quentin-z80/ASM1061/README.md

# ASM1061

ASM1061 based PCIe to SATA card

Manufactured using JLCPCB's JLC3313 stackup



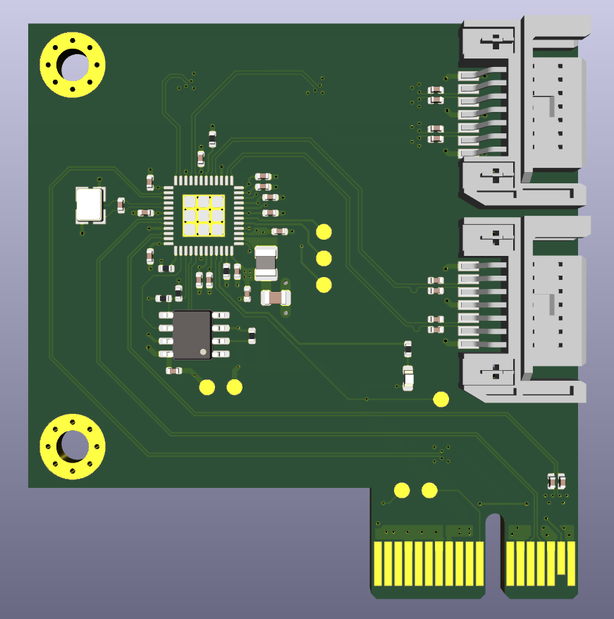
[picture p1: ASM1061_render.png]
