quentin-z80/ASM1061/ASM1061.kicad_pcb

## KiCad design ASM1061.kicad_pcb (2022-08-09)

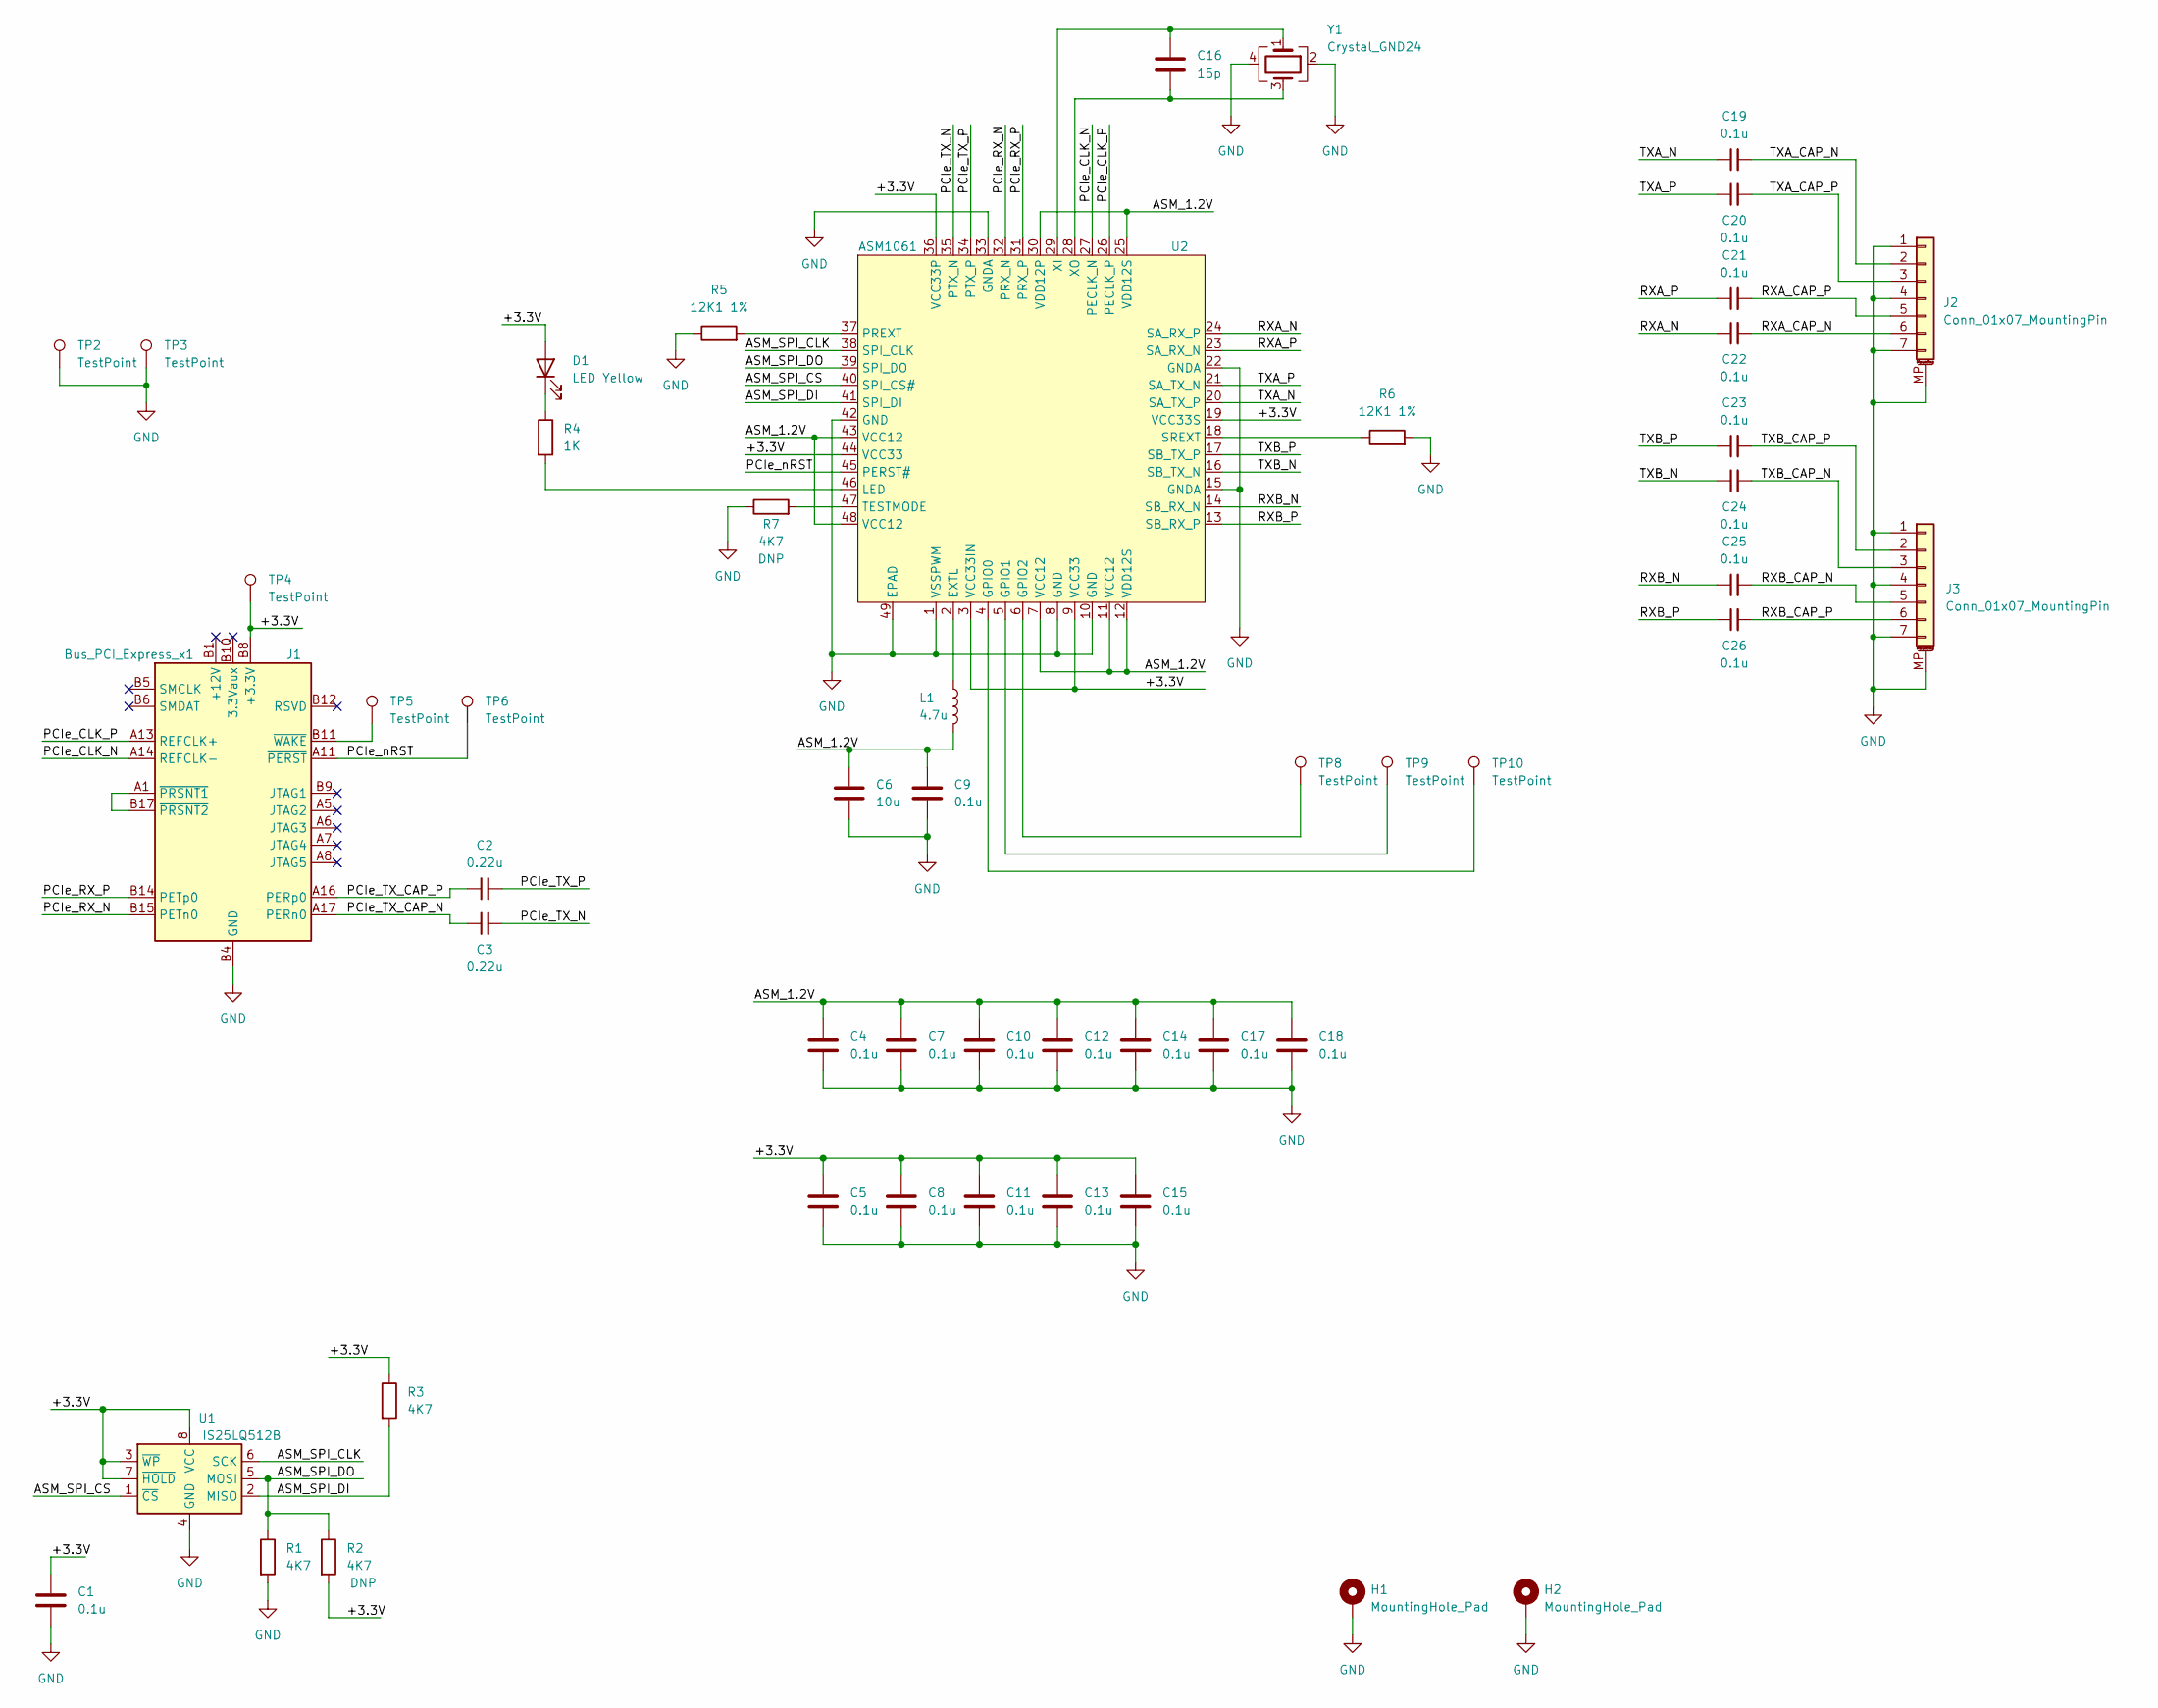
[picture p2: schematic ASM1061.kicad_sch]

Parts:
C1, C4, C5, C7, C8, C9, C10, C11, C12, C13, C14, C15, C17, C18, C19, C20, C21, C22, C23, C24, C25, C26: 0.1u; C_0402_1005Metric; MFG_PN GCM155R71C104KA55D; DigiKey_PN 490-4759-1-ND
C2, C3: 0.22u; C_0402_1005Metric; MFG_PN GCM155R71C224KE02D; DigiKey_PN 490-10671-1-ND
C6: 10u; C_0805_2012Metric; MFG_PN GRM21BR70J106KA73L; DigiKey_PN 490-GRM21BR70J106KA73LCT-ND
C16: 15p; C_0402_1005Metric; MFG_PN GCM1555C1H150JA16D; DigiKey_PN 490-11147-1-ND
D1: LED Yellow; LED_0603_1608Metric; MFG_PN SML-D12Y1WT86; DigiKey_PN SML-D12Y1WT86CT-ND
H1, H2: MountingHole_Pad; MountingHole_3.2mm_M3_Pad_Via
J1: Bus_PCI_Express_x1; BUS_PCIexpress_x1
J2, J3: Conn_01x07_MountingPin; 0674901220; MFG_PN 0470804005; DigiKey_PN WM19112CT-ND
L1: 4.7u; L_1008_2520Metric; MFG_PN CVH252009-4R7M; DigiKey_PN CVH252009-4R7MCT-ND
R1, R2, R3, R7: 4K7; R_0402_1005Metric; MFG_PN RC0402JR-074K7L; DigiKey_PN 311-4.7KJRCT-ND
R4: 1K; R_0402_1005Metric; MFG_PN RC0402JR-071KL; DigiKey_PN 311-1.0KJRCT-ND
R5, R6: 12K1 1%; R_0402_1005Metric; MFG_PN RC0402FR-0712K1L; DigiKey_PN 311-12.1KLRCT-ND
TP2, TP3, TP4, TP5, TP6, TP8, TP9, TP10: TestPoint; TestPoint_Pad_D1.5mm
U1: IS25LQ512B; SOIC-8_3.9x4.9mm_P1.27mm; MFG_PN IS25LQ512B-JNLE; DigiKey_PN 706-1325-ND
U2: ASM1061; VQFN-48-1EP_7x7mm_P0.5mm_EP4.1x4.1mm_ThermalVias
Y1: Crystal_GND24; Crystal_SMD_3225-4Pin_3.2x2.5mm; MFG_PN CX3225SB20000H0FLJCC; DigiKey_PN 1253-1744-1-ND

Connections:
/+3.3V: C1.1, C5.1, C8.1, C11.1, C13.1, C15.1, D1.2 (A), J1.A9 (+3.3V), J1.A10 (+3.3V), J1.B8 (+3.3V), R2.2, R3.1, TP4.1, U1.3 (~WP), U1.7 (~HOLD), U1.8 (VCC), U2.3 (VCC33IN), U2.9 (VCC33), U2.19 (VCC33S), U2.36 (VCC33P), U2.44 (VCC33)
/ASM_1.2V: C4.1, C6.1, C7.1, C9.1, C10.1, C12.1, C14.1, C17.1, C18.1, L1.2, U2.7 (VCC12), U2.11 (VCC12), U2.12 (VDD12S), U2.25 (VDD12S), U2.30 (VDD12P), U2.43 (VCC12), U2.48 (VCC12)
/ASM_SPI_CLK: U1.6 (SCK), U2.38 (SPI_CLK)
/ASM_SPI_CS: U1.1 (~CS), U2.40 (SPI_CS#)
/ASM_SPI_DI: R3.2, U1.2 (MISO), U2.41 (SPI_DI)
/ASM_SPI_DO: R1.1, R2.1, U1.5 (MOSI), U2.39 (SPI_DO)
/PCIe_CLK_N: J1.A14 (REFCLK-), U2.27 (PECLK_N)
/PCIe_CLK_P: J1.A13 (REFCLK+), U2.26 (PECLK_P)
/PCIe_RX_N: J1.B15 (PETn0), U2.32 (PRX_N)
/PCIe_RX_P: J1.B14 (PETp0), U2.31 (PRX_P)
/PCIe_TX_CAP_N: C3.1, J1.A17 (PERn0)
/PCIe_TX_CAP_P: C2.1, J1.A16 (PERp0)
/PCIe_TX_N: C3.2, U2.35 (PTX_N)
/PCIe_TX_P: C2.2, U2.34 (PTX_P)
/PCIe_nRST: J1.A11 (~PERST), TP6.1, U2.45 (PERST#)
/RXA_CAP_N: C22.2, J2.6
/RXA_CAP_P: C21.2, J2.5
/RXA_N: C22.1, U2.24 (SA_RX_P)
/RXA_P: C21.1, U2.23 (SA_RX_N)
/RXB_CAP_N: C25.2, J3.5
/RXB_CAP_P: C26.2, J3.6
/RXB_N: C25.1, U2.14 (SB_RX_N)
/RXB_P: C26.1, U2.13 (SB_RX_P)
/TXA_CAP_N: C19.2, J2.2
/TXA_CAP_P: C20.2, J2.3
/TXA_N: C19.1, U2.20 (SA_TX_P)
/TXA_P: C20.1, U2.21 (SA_TX_N)
/TXB_CAP_N: C24.2, J3.3
/TXB_CAP_P: C23.2, J3.2
/TXB_N: C24.1, U2.16 (SB_TX_N)
/TXB_P: C23.1, U2.17 (SB_TX_P)
GND: C1.2, C4.2, C5.2, C6.2, C7.2, C8.2, C9.2, C10.2, C11.2, C12.2, C13.2, C14.2, C15.2, C17.2, C18.2, H1.1, H2.1, J1.A4 (GND), J1.A12 (GND), J1.A15 (GND), J1.A18 (GND), J1.B4 (GND), J1.B7 (GND), J1.B13 (GND), J1.B16 (GND), J1.B18 (GND), J2.1, J2.4, J2.7, J2.MP (MountPin), J3.1, J3.4, J3.7, J3.MP (MountPin), R1.2, R5.1, R6.2, R7.1, TP2.1, TP3.1, U1.4 (GND), U2.1 (VSSPWM), U2.8 (GND), U2.10 (GND), U2.15 (GNDA), U2.22 (GNDA), U2.33 (GNDA), U2.42 (GND), U2.49 (EPAD), Y1.2, Y1.4
unnamed: C16.1, U2.29 (XI), Y1.1
unnamed: C16.2, U2.28 (XO), Y1.3
unnamed: D1.1 (K), R4.1
unnamed: J1.A1 (~PRSNT1), J1.B17 (~PRSNT2)
unnamed: J1.B11 (~WAKE), TP5.1
unnamed: L1.1, U2.2 (EXTL)
unnamed: R4.2, U2.46 (LED)
unnamed: R5.2, U2.37 (PREXT)
unnamed: R6.1, U2.18 (SREXT)
unnamed: R7.2, U2.47 (TESTMODE)
unnamed: TP8.1, U2.6 (GPIO2)
unnamed: TP9.1, U2.5 (GPIO1)
unnamed: TP10.1, U2.4 (GPIO0)

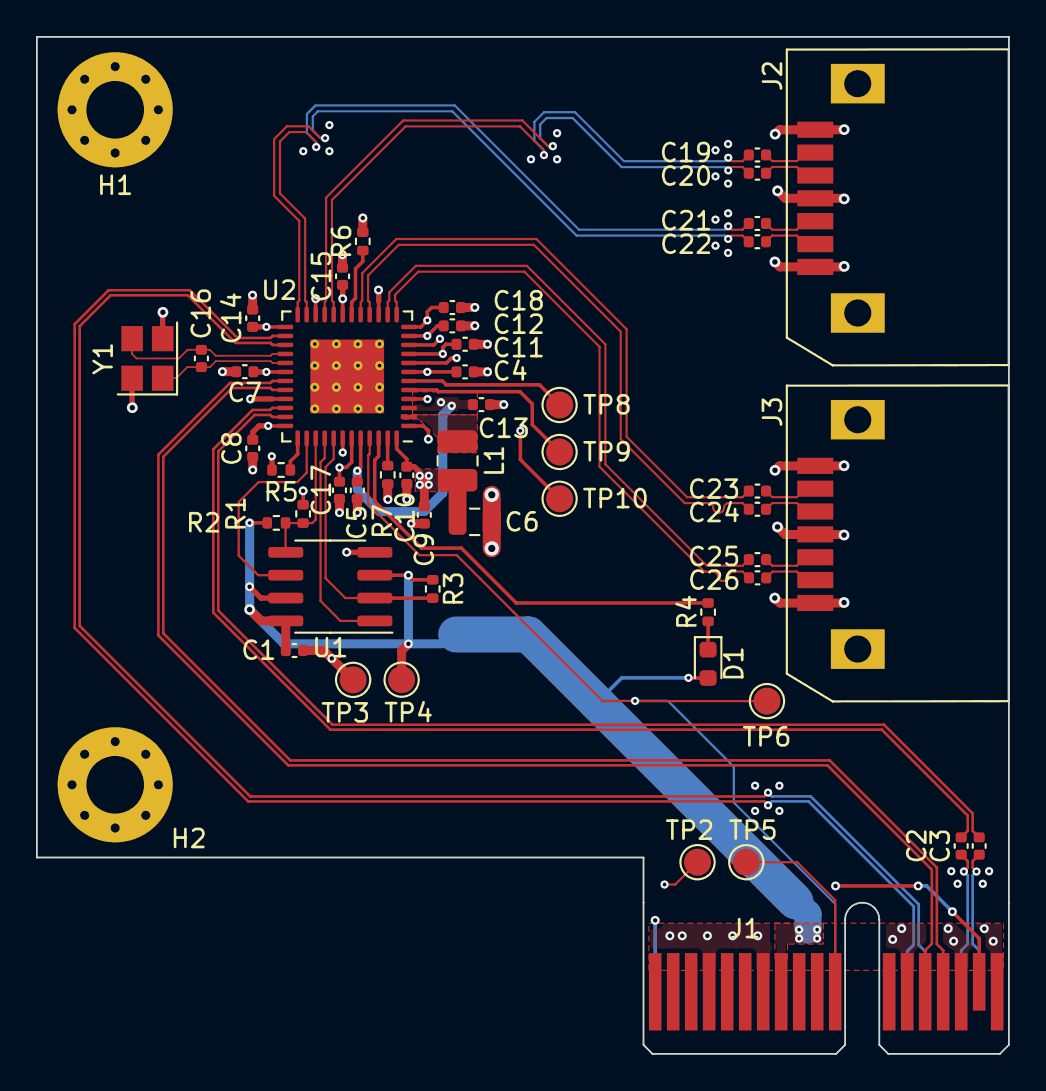
[picture p3: board ASM1061.kicad_pcb from above]

Board: 4 copper layers, 54.0 x 56.5 mm, 51 parts (0 on the bottom side), 45 nets.
