quentin-z80/ASM1061/(commit log)

2022-03-01 import project into git
    [ASM1061.kicad_pcb, ASM1061.kicad_sch]
2022-08-09 resave files in new kicad version
    [ASM1061.kicad_pcb, ASM1061.kicad_sch]
2022-08-09 README.md: add pcb manufacturing info
2022-08-09 use solid ground pour for asm1061, increase power trace size
    [ASM1061.kicad_pcb]
